daewonlee81-glitch/husky_spike_esp32/docs/bat18650_power.png

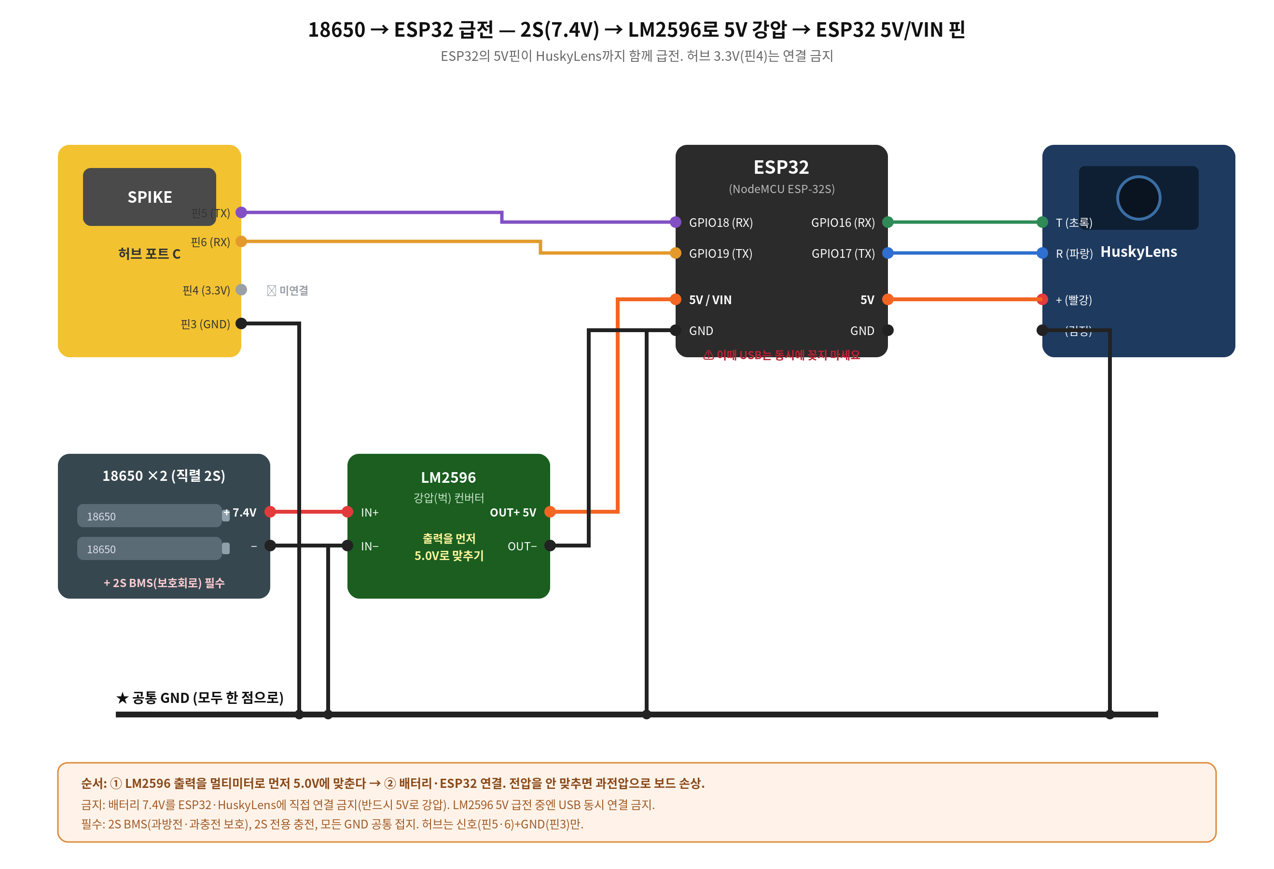
docs/bat18650_power.png
