daewonlee81-glitch/husky_spike_esp32/docs/cap_diagram.png

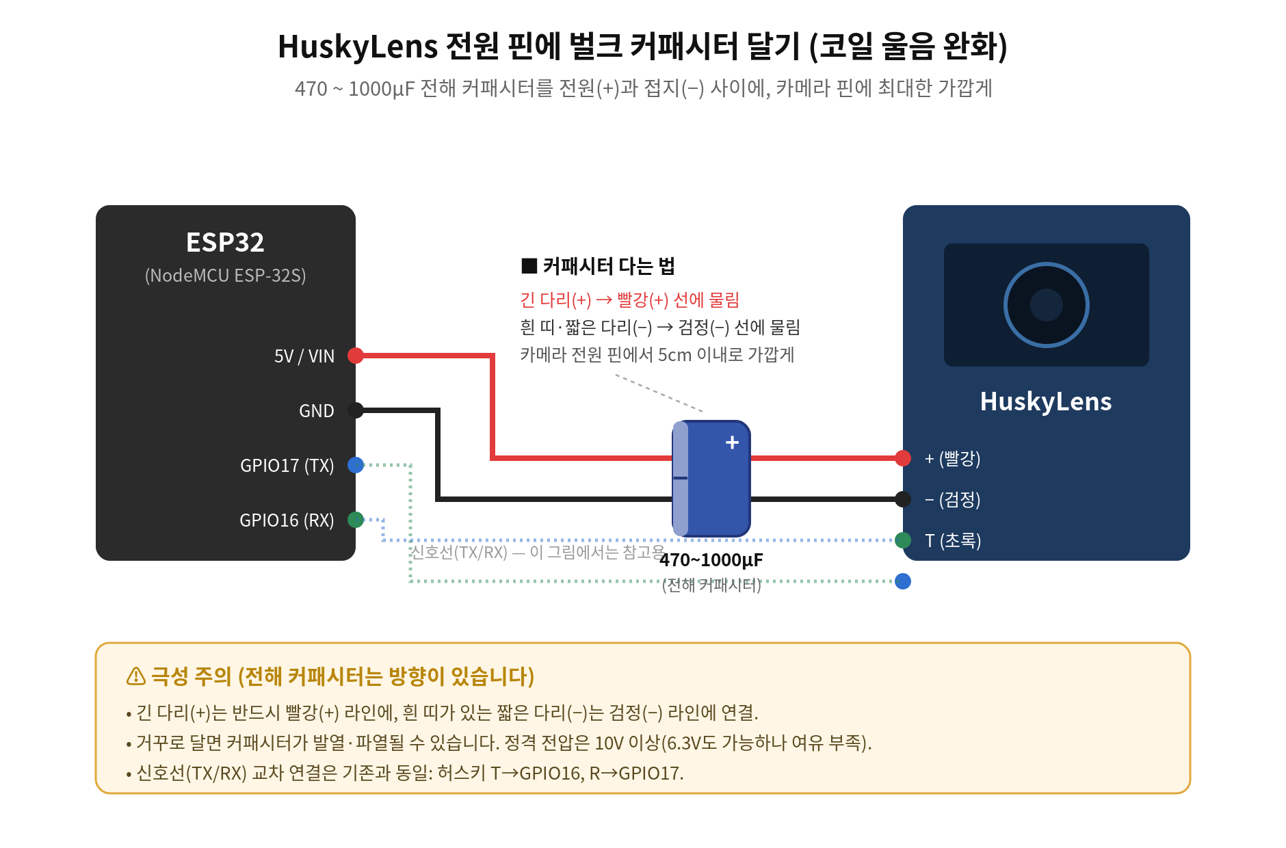
docs/cap_diagram.png
