daewonlee81-glitch/husky_spike_esp32/docs/colortrack_blocks.png

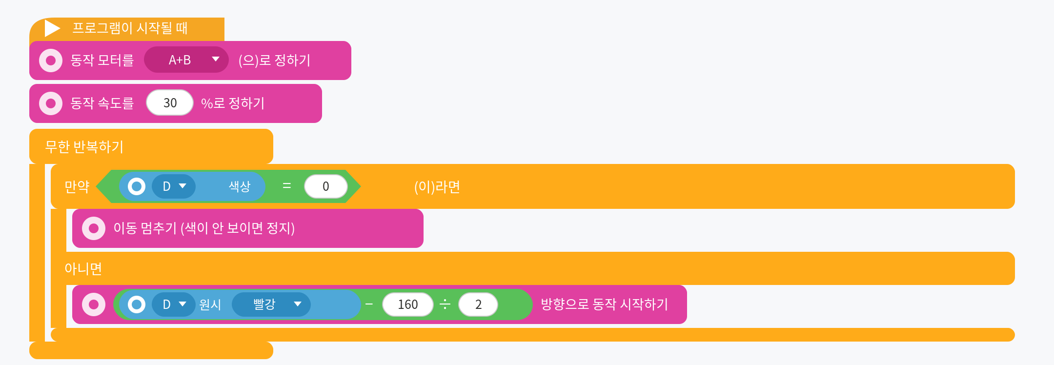
docs/colortrack_blocks.png
