daewonlee81-glitch/husky_spike_esp32/docs/dfr0968_power.png

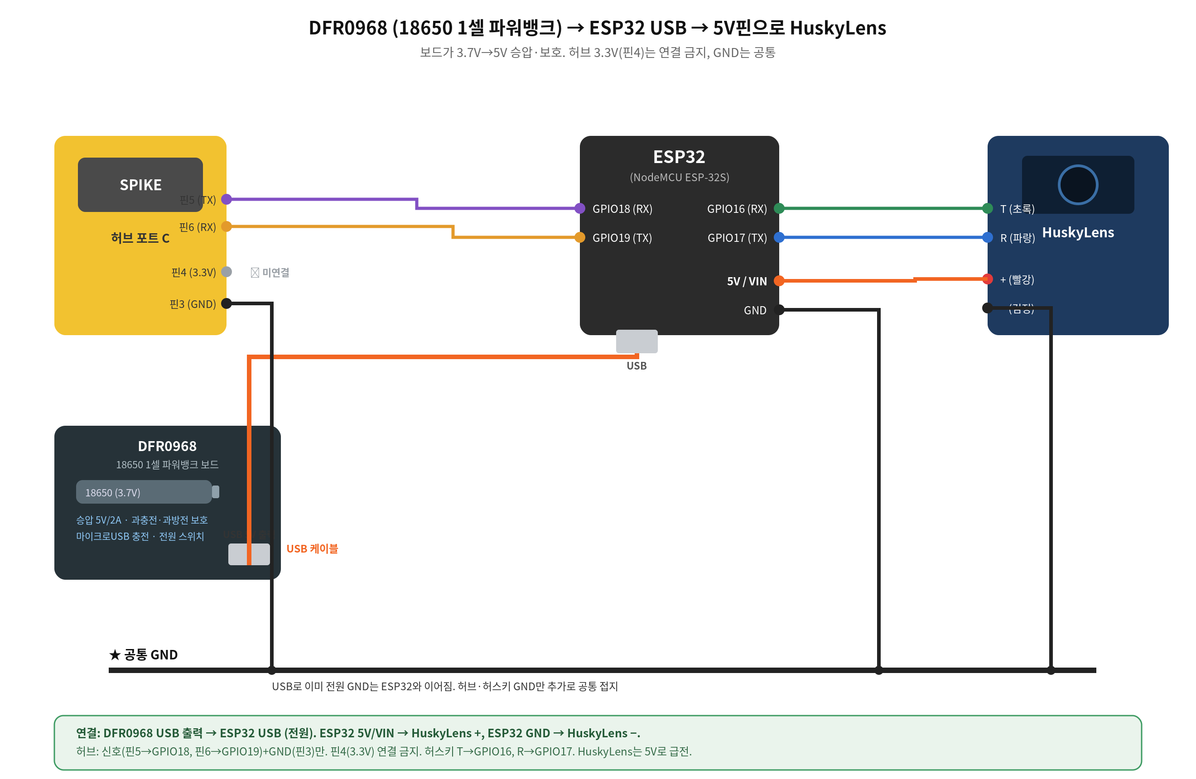
docs/dfr0968_power.png
