daewonlee81-glitch/husky_spike_esp32/docs/sep_power.png

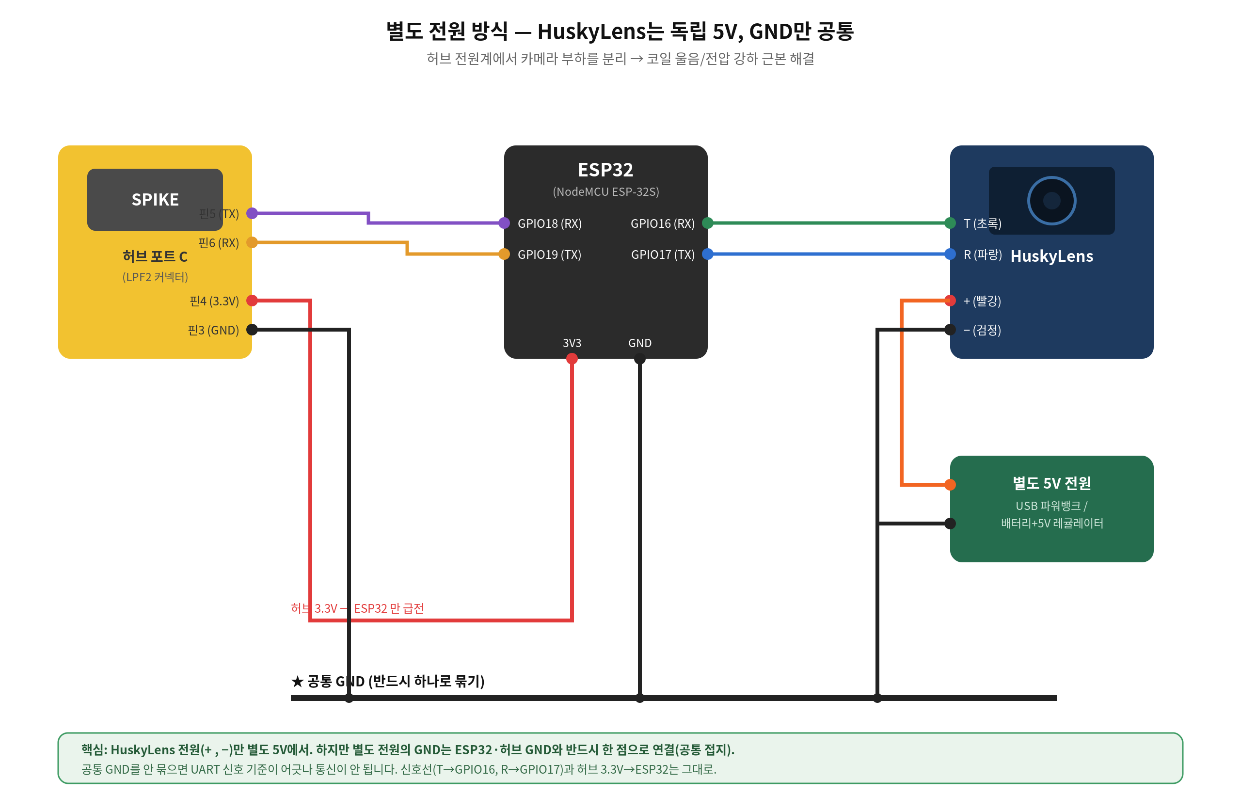
docs/sep_power.png
