daewonlee81-glitch/husky_spike_esp32/docs/smart_tracker_blocks.png

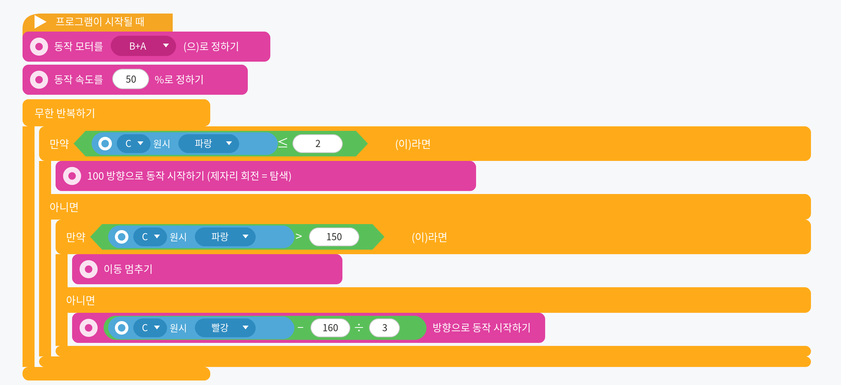
docs/smart_tracker_blocks.png
