daewonlee81-glitch/husky_spike_esp32/hardware/huskylens_lego_mount.stl

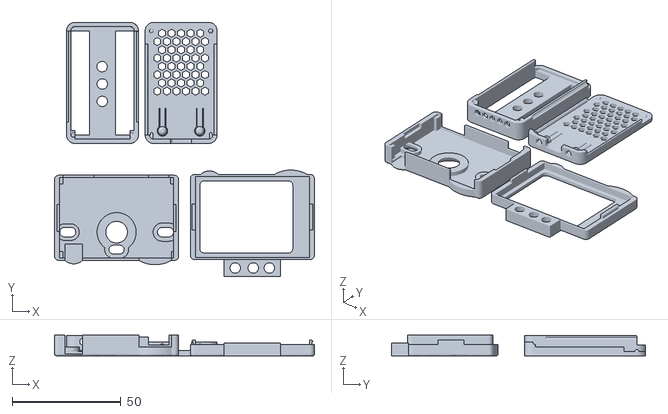
[picture p16: CAD file, 2026-07-14]
hardware/huskylens_lego_mount.stl
119.7 x 117.1 x 9.60
