daewonlee81-glitch/husky_spike_esp32/docs/full_wiring_cap.png

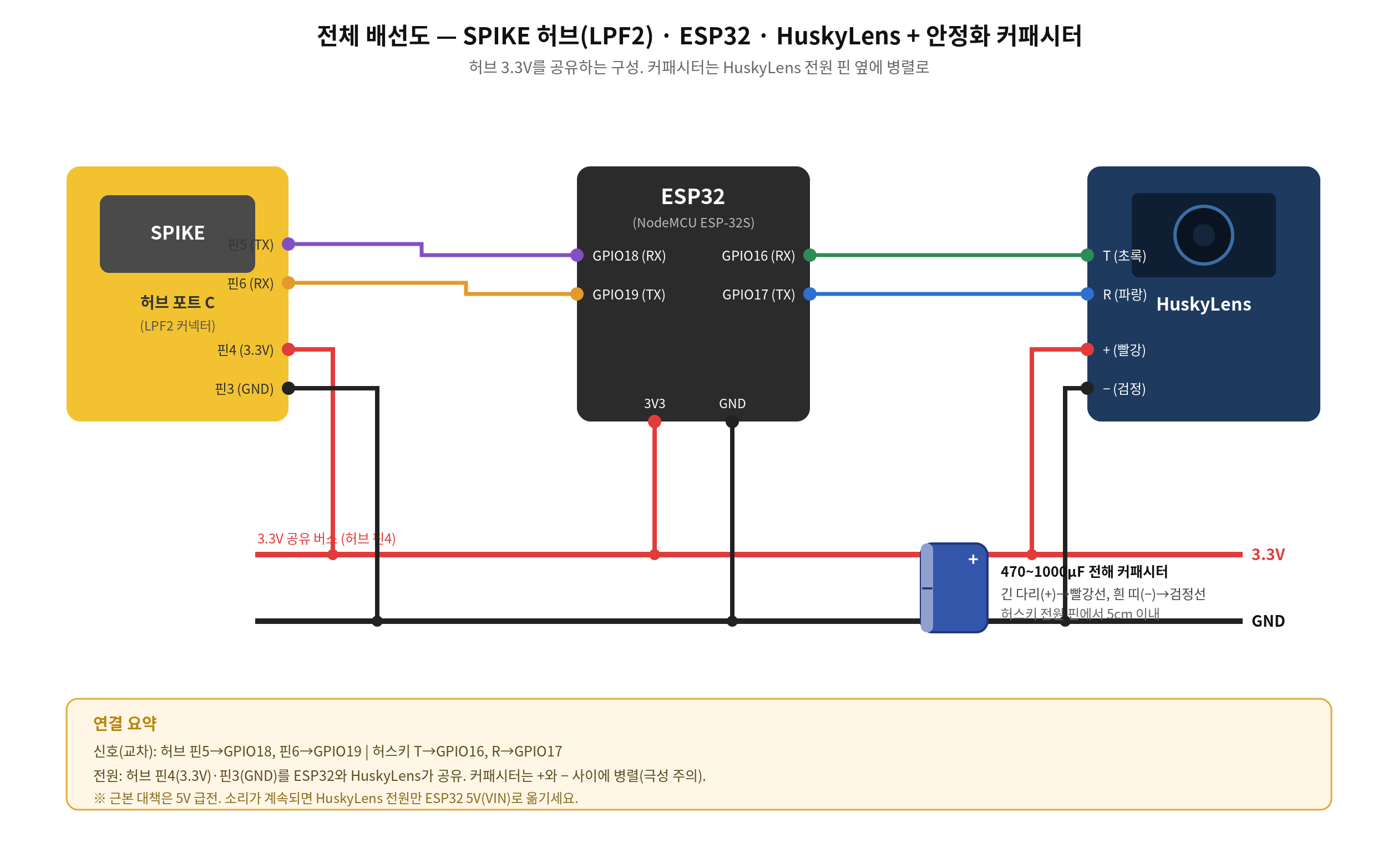
docs/full_wiring_cap.png
