daewonlee81-glitch/husky_spike_esp32/firmware/pupremote.py

# Source: https://github.com/antonvh/PUPRemote/blob/main/src/pupremote.py  (v2.1)
__author__ = "Anton Vanhoucke & Ste7an"
__copyright__ = "Copyright 2023,2024 AntonsMindstorms.com"
__license__ = "GPL"
__version__ = "2.1"
__status__ = "Production"

try:
    from pybricks.iodevices import PUPDevice
    from pybricks.tools import wait, run_task
    import ustruct as struct

    side = "Hub"
except ImportError:
    # We surely aren't on pybricks. Probably on the sensor side (openmv or lms-esp32)
    side = "Sensor"

    # Avoid errors when using Pybricks classes and functions.
    class PUPDevice:
        def __init__(self, port):
            pass

        def read(self, mode):
            pass

        def write(self, mode, data):
            pass

    def wait(ms):
        pass

    # Import modules for sensor side only.
    import asyncio
    import lpf2
    import struct
    from collections import deque

try:
    from micropython import const
except ImportError:
    # Create quick polyfill on platforms that don't support it
    def const(x):
        return x


MAX_PKT = const(16)
MAX_COMMANDS = const(16)
MAX_COMMAND_QUEUE_LENGTH = const(10)

# Result holder indices
DONE = const(0)
RESULT = const(1)
ERROR = const(2)

# Dictionary keys
NAME = const(0)
SIZE = const(1)
TO_HUB_FORMAT = const(2)
FROM_HUB_FORMAT = const(3)
CALLABLE = const(4)
ARGS_TO_HUB = const(5)
ARGS_FROM_HUB = const(6)

#: WeDo Ultrasonic sensor id
WEDO_ULTRASONIC = const(35)
#: SPIKE Color sensor id
SPIKE_COLOR = const(61)
#: SPIKE Ultrasonic sensor id
SPIKE_ULTRASONIC = const(62)

CALLBACK = const(0)
CHANNEL = const(1)


class PUPRemote:
    """Base class for PUPRemoteHub and PUPRemoteSensor. Don't use this class directly.

    Defines a list of commands and their formats. Contains encoding/decoding
    functions for communication between hub and sensor.

    Args:
        max_packet_size: Maximum packet size in bytes, defaults to 16 for Pybricks compatibility.
    """

    def __init__(self, max_packet_size=MAX_PKT):
        self.commands = []
        self.modes = {}
        self.max_packet_size = max_packet_size

    def add_channel(self, mode_name: str, to_hub_fmt: str = ""):
        """Define a data channel to read on the hub.

        Use this function with identical parameters on both the sensor and the hub.
        You can call a channel like a command, but to update the data on the sensor
        side, you need to `update_channel(<name>, *args)`.

        Args:
            mode_name: The name of the mode you defined on the sensor side.
            to_hub_fmt: The format string of the data sent from the sensor to the hub.
                Use 'repr' to receive any python object. Or use a struct format string.
                See https://docs.python.org/3/library/struct.html
        """
        self.add_command(mode_name, to_hub_fmt=to_hub_fmt, command_type=CHANNEL)

    def add_command(
        self,
        mode_name: str,
        to_hub_fmt: str = "",
        from_hub_fmt: str = "",
        command_type=CALLBACK,
    ):
        """Define a remote call.

        Use this function with identical parameters on both the sensor and the hub.

        Args:
            mode_name: The name of the mode you defined on the sensor side.
            to_hub_fmt: The format string of the data sent from the sensor to the hub.
                Use 'repr' to receive any python object. Or use a struct format string.
                See https://docs.python.org/3/library/struct.html
            from_hub_fmt: The format string of the data sent from the hub.
            command_type: CALLBACK or CHANNEL (internal).
        """
        if to_hub_fmt == "repr" or from_hub_fmt == "repr":
            msg_size = self.max_packet_size
            num_args_from_hub = -1
            num_args_to_hub = -1
        else:
            size_to_hub_fmt = struct.calcsize(to_hub_fmt)
            size_from_hub_fmt = struct.calcsize(from_hub_fmt)
            msg_size = max(size_to_hub_fmt, size_from_hub_fmt)
            num_args_to_hub = len(
                struct.unpack(to_hub_fmt, bytearray(struct.calcsize(to_hub_fmt)))
            )
            num_args_from_hub = len(
                struct.unpack(from_hub_fmt, bytearray(struct.calcsize(from_hub_fmt)))
            )

        assert len(self.commands) < MAX_COMMANDS, "Command limit exceeded"
        assert msg_size <= self.max_packet_size, "Payload exceeds maximum packet size"
        self.commands.append(
            {
                NAME: mode_name,
                TO_HUB_FORMAT: to_hub_fmt,
                SIZE: msg_size,
                ARGS_TO_HUB: num_args_to_hub,
            }
        )
        if command_type == CALLBACK:
            self.commands[-1][FROM_HUB_FORMAT] = from_hub_fmt
            self.commands[-1][ARGS_FROM_HUB] = num_args_from_hub

        # Build a dictionary of mode names and their index
        self.modes[mode_name] = len(self.commands) - 1

    def decode(self, fmt: str, data: bytes):
        if fmt == "repr":
            # Remove trailing zero's (b'\x00') and eval the string
            clean = bytearray([c for c in data if c != 0])
            if clean:
                return (eval(clean),)
            else:
                # Probably nothing left after stripping zero's
                return ("",)
        else:
            size = struct.calcsize(fmt)
            data = struct.unpack(fmt, data[:size])
        return data

    def encode(self, size, format, *argv):
        if format == "repr":
            s = bytes(repr(*argv), "UTF-8")
        else:
            s = struct.pack(format, *argv)
        assert len(s) <= size, "Payload exceeds maximum packet size"
        return s


class PUPRemoteSensor(PUPRemote):
    """Emulate a PUPRemote sensor for communication with a hub.

    Use this class on the sensor side (ESP32, OpenMV, etc.). Enables 8V power on
    the M+ wire if configured.

    Args:
        sensor_id: The id of the sensor to emulate, defaults to SPIKE_ULTRASONIC.
        power: Set to True to enable 8V power on M+ wire, defaults to False.
        max_packet_size: Set to 16 for Pybricks compatibility, defaults to 32.
    """

    def __init__(
        self,
        sensor_id=SPIKE_ULTRASONIC,
        power=False,
        max_packet_size=MAX_PKT,
        **kwargs,  # backward compatibility
    ):
        super().__init__(max_packet_size)
        self.power = power
        self.max_packet_size = max_packet_size
        self.lpup = lpf2.LPF2([], sensor_id=sensor_id, max_packet_size=max_packet_size)
        self._callback_queue = deque((), MAX_COMMAND_QUEUE_LENGTH)
        self._callback_lock = asyncio.Lock()

    def connected(self):
        """Check if connected to a hub.

        Returns:
            True if connected to a hub, False otherwise.
        """
        return self.lpup.connected

    def add_command(
        self,
        mode_name: str,
        to_hub_fmt: str = "",
        from_hub_fmt: str = "",
        command_type=CALLBACK,
    ):
        super().add_command(mode_name, to_hub_fmt, from_hub_fmt, command_type)
        writeable = 0
        if command_type == CALLBACK:
            self.commands[-1][CALLABLE] = eval(mode_name)
        if from_hub_fmt != "":
            writeable = lpf2.ABSOLUTE
        max_mode_name_len = 5 if self.power else 11
        assert (
            len(mode_name) <= max_mode_name_len
        ), "Name length must be <= {} with power={}".format(
            max_mode_name_len, self.power
        )
        if self.power:
            mode_name = (
                mode_name.encode("ascii")
                + b" " * (5 - len(mode_name))
                + b"\x00\x80\x00\x00\x00\x05\x04"
            )
        self.lpup.modes.append(
            self.lpup.mode(
                mode_name,
                self.commands[-1][SIZE],  # Size of the last command we added.
                lpf2.DATA8,
                writeable,
            )
        )

    async def _heartbeat_loop(self, interval_ms: int):
        """Continuously call heartbeat at fixed interval and enqueue callbacks"""
        while True:
            data = self.lpup.heartbeat()
            if data:
                async with self._callback_lock:
                    self._callback_queue.append(data)
            await asyncio.sleep(interval_ms / 1000)

    async def _process_callbacks(self):
        """Process incoming callbacks from queue serially"""
        while True:
            await asyncio.sleep(0)  # Yield to allow _heartbeat_loop to enqueue
            async with self._callback_lock:
                if self._callback_queue:
                    pl, mode = self._callback_queue.popleft()
                else:
                    continue

            if CALLABLE in self.commands[mode]:
                result = None
                args = self.decode(self.commands[mode][FROM_HUB_FORMAT], pl)
                result = await self.commands[mode][CALLABLE](*args)
                self._send_response(mode, result)

    def _send_response(self, mode, result):
        num_args = self.commands[mode][ARGS_TO_HUB]

        if result is None:
            assert num_args <= 0, "{}() did not return value(s)".format(
                self.commands[mode][NAME]
            )
        else:
            if not isinstance(result, tuple):
                result = (result,)
            if num_args >= 0:
                assert num_args == len(
                    result
                ), "{}() returned {} value(s) instead of expected {}".format(
                    self.commands[mode][NAME], len(result), num_args
                )
            pl = self.encode(
                self.commands[mode][SIZE],
                self.commands[mode][TO_HUB_FORMAT],
                *result,
            )
            self.lpup.send_payload(pl, mode)

    async def process_async(self, interval_ms: int = 50):
        """Start async heartbeat and callback processing.

        Runs two asynchronous tasks concurrently:
        - Heartbeat loop maintaining communication at minimum 15 Hz
        - Callback processing loop handling queued commands

        Args:
            interval_ms: The interval in milliseconds between heartbeats.
                Must be maximum 66ms to maintain minimum 15 Hz frequency. Defaults to 50ms.

        Raises:
            asyncio.CancelledError: If either task is cancelled during execution.
        """
        hb_task = asyncio.create_task(self._heartbeat_loop(interval_ms))
        cb_task = asyncio.create_task(self._process_callbacks())
        await asyncio.gather(hb_task, cb_task)

    def process(self):
        """Process commands and communication with the hub.

        Call this function in your main loop, preferably at least once every 20ms.
        Handles hub communication, auto-connect, and command invocation.

        Returns:
            True if connected to the hub, False otherwise.
        """
        data = self.lpup.heartbeat()

        # heartbeat() returns (payload, mode) when the hub writes data to us.
        # When the hub only polls or reads (e.g. pup.call('joy') with to_hub_fmt
        # only), it returns None — use the active LPF2 mode in that case.
        if data is not None:
            pl, mode = data
        else:
            mode = self.lpup.current_mode

        if CALLABLE in self.commands[mode]:
            result = None
            if data is not None:
                # Hub-to-sensor command: decode args from hub and call callback.
                args = self.decode(self.commands[mode][FROM_HUB_FORMAT], pl)
                result = self.commands[mode][CALLABLE](*args)
            else:
                # Sensor-to-hub command: hub read without writing. We must still
                # invoke the callback to produce fresh data (see issue #51).
                # TypeError: callback expects hub args but none were sent.
                try:
                    result = self.commands[mode][CALLABLE]()
                except TypeError:
                    pass
            # Skip send when callback failed; allow None for void commands.
            if result is not None or self.commands[mode][ARGS_TO_HUB] <= 0:
                self._send_response(mode, result)
        elif data is None:
            # Channel (no callback): push data stored via update_channel().
            self.lpup.send_payload()

        return self.connected()

    def update_channel(self, mode_name: str, *argv):
        """Update values in sensor memory for hub retrieval. This method has no
        async version, as it only updates local memory. It is non blocking.

        Simpler alternative to defining a function called from the hub.

        Args:
            mode_name: Mode name you defined when you used `add_channel()`.
            *argv: Values to update.
        """
        mode = self.modes[mode_name]

        pl = self.encode(
            self.commands[mode][SIZE], self.commands[mode][TO_HUB_FORMAT], *argv
        )
        self.lpup.update_payload(pl, mode)


class PUPRemoteHub(PUPRemote):
    """Communicate with a PUPRemoteSensor from a Pybricks hub.

    Use on the hub side running Pybricks. Copy the commands you defined on the sensor
    side to the hub side using add_command() and add_channel().

    Args:
        port: The port to which the PUPRemoteSensor is connected (e.g., Port.A).
        max_packet_size: Set to 16 for Pybricks compatibility, defaults to 32.
    """

    def _int8_to_uint8(self, arr):
        return [((i + 128) & 0xFF) - 128 for i in arr]

    def __init__(self, port, max_packet_size=MAX_PKT):
        super().__init__(max_packet_size)
        self.port = port
        try:
            self.pup_device = PUPDevice(port)
        except OSError:
            self.pup_device = None
            print("Check wiring and remote script. Unable to connect on ", self.port)
            raise
        # Multitask stuff
        self._queue = []
        self._multitask_loop_running = False

    def add_command(
        self, mode_name, to_hub_fmt="", from_hub_fmt="", command_type=CALLBACK
    ):
        super().add_command(mode_name, to_hub_fmt, from_hub_fmt, command_type)
        # Check the newly added commands against the advertised modes.
        modes = self.pup_device.info()["modes"]
        n = len(self.commands) - 1  # Zero indexed mode number
        assert len(self.commands) <= len(modes), "More commands than on remote side"
        assert (
            mode_name == modes[n][0].rstrip()
        ), "Expected '{}' as mode {}, but got '{}'".format(
            modes[n][0].rstrip(), n, mode_name
        )
        assert (
            self.commands[-1][SIZE] == modes[n][1]
        ), "Different parameter size than on remote side. Check formats."

    def call(self, mode_name: str, *argv, wait_ms=0):
        """Call a remote function on the sensor side.

        Args:
            mode_name: The name of the mode you defined on both sides.
            *argv: Arguments to pass to the remote function.
            wait_ms: Time to wait before reading after sending (optional).
                Defaults to 0ms. A good value is `struct.calcsize(from_hub_fmt) * 1.5` (ms)

        Returns:
            The return value from the remote function, or a tuple of values.

        Raises:
            AssertionError: If called during a multitask operation.
        """
        assert (
            not run_task()
        ), "Use 'call_multitask' instead of 'call', with multiple start blocks or multitask blocks"

        mode = self.modes[mode_name]
        size = self.commands[mode][SIZE]

        if FROM_HUB_FORMAT in self.commands[mode]:
            num_args = self.commands[mode][ARGS_FROM_HUB]
            if num_args >= 0:
                assert (
                    len(argv) == num_args
                ), "Expected {} argument(s) in call '{}'".format(num_args, mode_name)
            payl = self.encode(size, self.commands[mode][FROM_HUB_FORMAT], *argv)
            self.pup_device.write(
                mode, self._int8_to_uint8(tuple(payl + b"\x00" * (size - len(payl))))
            )
            wait(wait_ms)

        data = self.pup_device.read(mode)
        raw_data = bytes([b if b>=0 else b+256 for b in data])
        result = self.decode(self.commands[mode][TO_HUB_FORMAT], raw_data)
        # Convert tuple size 1 to single value
        return result[0] if len(result) == 1 else result

    async def call_multitask(self, command_name: str, *argv, wait_ms=0):
        """Call a remote function asynchronously for use with Pybricks multitask.

        Make sure to run process_async() as a separate task before using this.

        Args:
            command_name: The name of the command.
            *argv: Arguments to pass to the remote function.
            wait_ms: Time to wait before reading after sending. Defaults to 0ms.

        Returns:
            The return value from the remote function, or a tuple of values.
        """
        if not self._multitask_loop_running:
            raise AssertionError(
                "Start 'process_async' as a seperate task (coroutine) before using 'call_multitask()'"
            )

        result_holder = [False, None, None]  # [done, result, error]
        self._queue.append((command_name, argv, wait_ms, result_holder))

        while not result_holder[DONE]:
            await wait(1)  # cooperative multitasking

        if result_holder[ERROR]:
            raise result_holder[ERROR]
        return result_holder[RESULT]

    async def _execute_call(self, mode_name: str, *argv, wait_ms=0):
        mode = self.modes[mode_name]
        size = self.commands[mode][SIZE]

        if FROM_HUB_FORMAT in self.commands[mode]:
            num_args = self.commands[mode][ARGS_FROM_HUB]
            if num_args >= 0:
                assert (
                    len(argv) == num_args
                ), "Expected {} argument(s) in call '{}'".format(num_args, mode_name)
            payl = self.encode(size, self.commands[mode][FROM_HUB_FORMAT], *argv)
            await self.pup_device.write(
                mode, self._int8_to_uint8(tuple(payl + b"\x00" * (size - len(payl))))
            )
            await wait(wait_ms)

        data = await self.pup_device.read(mode)
        raw_data = bytes([b if b>=0 else b+256 for b in data])
        result = self.decode(self.commands[mode][TO_HUB_FORMAT], raw_data)
        # Convert tuple size 1 to single value
        return result[0] if len(result) == 1 else result

    async def process_async(self):
        """
        Process multitask MicroPUP calls in a queue to avoid EAGAIN or IOERR.
        """
        self._multitask_loop_running = True
        running = False
        while True:
            if self._queue and not running:
                running = True
                command_name, argv, wait_ms, result_holder = self._queue.pop(0)

                try:
                    result = await self._execute_call(
                        command_name, *argv, wait_ms=wait_ms
                    )
                    result_holder[RESULT] = result
                except Exception as e:
                    result_holder[ERROR] = e
                    print(e)
                    raise
                finally:
                    result_holder[DONE] = True
                    running = False
            await wait(1)
