daewonlee81-glitch/husky_spike_esp32/(commit log)

2026-06-22 HuskyLens + ESP32 + SPIKE Prime color tracking (color-sensor combo emulation)
2026-07-14 Add English README, 3D-printable HuskyLens mount (STL), real word-block example
    - README.en.md: full English translation
    - hardware/huskylens_lego_mount.stl: LEGO Technic mount for HuskyLens
    - docs/redball_blocks.png: actual working word-block program (motors A+E, speed 15%, X<120 / X>200 / stop)
    - examples/red_ball_tracker.py: Python version matching the word blocks
    - docs/: elementary-school lesson book (DOCX/PDF)
    - tools/install_firmware.py: find firmware files in ../firmware/
    [huskylens_lego_mount.stl]
2026-07-14 README: add 'Related work' section comparing with LMS-ESP32/MyOwnBricks/HuskyLensSPIKE
2026-07-15 Redesign power: USB-powered ESP32 (5V pin feeds HuskyLens) as recommended
    - README: new 'Powering it' section — USB power (recommended), separate 5V, or hub 3.3V+cap
    - docs: usb_power.png, sep_power.png, cap_diagram.png, full_wiring_cap.png
    - Wiring table: hub pin4 (3.3V) no longer shared to camera; common GND emphasized
    - examples/object_follower.py + docs/follow_blocks.png: follow with forward/back
2026-07-15 Add battery power options: DFR0968 single-18650 power bank + 2S 18650 + LM2596
    - docs/dfr0968_power.png: single 18650 via DFR0968 boost/protection board -> ESP32 USB
    - docs/bat18650_power.png: 2S 18650 + BMS + LM2596 -> 5V -> ESP32 VIN
    - README power table: add both battery methods
2026-07-20 Support all HuskyLens algorithms incl. line tracking
    Firmware (main.py):
    - Rewritten with full documentation of every algorithm's value mapping
    - request_first() now returns the frame kind and auto-detects Block vs Arrow
    - Arrow (Line Tracking) mapping: rawR=origin X, rawG=target X, rawB=target Y
    - Prints the detected mode (BLOCK/ARROW) when it changes, for easier debugging
    - Core logic unchanged: combo mode, heartbeat every loop, load_payload only, debounce
    Examples & docs:
    - examples/line_follower.py: line tracing with curve look-ahead
    - examples/smart_color_tracker.py: search + track + stop
    - docs/line_blocks.png, docs/smart_tracker_blocks.png: word-block versions
    - README (ko/en): block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
2026-07-21 Examples: color tracker + search/track/reverse (2-sensor), light + line updates
    - examples/color_tracker.py: proportional color tracking (steer to center)
    - examples/search_track_reverse.py: search -> approach (Y>200) -> drive -> floor-brightness reverse 30cm
    (Th = (bright+dark)/2 auto-calibration; vision on D, real color sensor on C)
    - firmware/main.py: WS2812 white camera light on GPIO26 at power-up
    - docs: search_blocks.png, colortrack_blocks.png
    - README: search example section, examples list
    [main.py]
